jrnelson90/tinderboxpedal/src.midi/README.md

# USB MIDI footswitch for Positive Grid Spark

Supported / tested USB MIDI footswitches: 

 - Icon G-Board

## Quick start

You will need:

 - a supported footswitch
 - a Raspberry Pi 4 (2Gb version should work, 4Gb version was used). It gets hot, invest a few $$s for good passive cooling enclosure. You will need a power supply as well, the official one may be the safest way
 - Ubuntu 20.04 LTS from https://ubuntu.com/download/raspberry-pi installed on a SD card

Unfortunately, my Pi doesn't boot with the MIDI controller attached, making it not possible to autostart the script in its current form. You will need a display and keyboard or set up SSH connction until the issue is resolved.

Following packages should be installed:

    sudo apt install pi-bluetooth
    sudo apt install python3-bluez
    sudo apt install python3-rtmidi

and restart the Pi.

Make sure that no other Bluetooth device is connected to your Spark, and start the script with

    python3 ./midibox.py

You should see messages about MIDI devices and Spark discovered (the Spark discovery may take some seconds)

The top row of the footswitch is changing amp presets.
