jrnelson90/tinderboxpedal/src/flame.gif

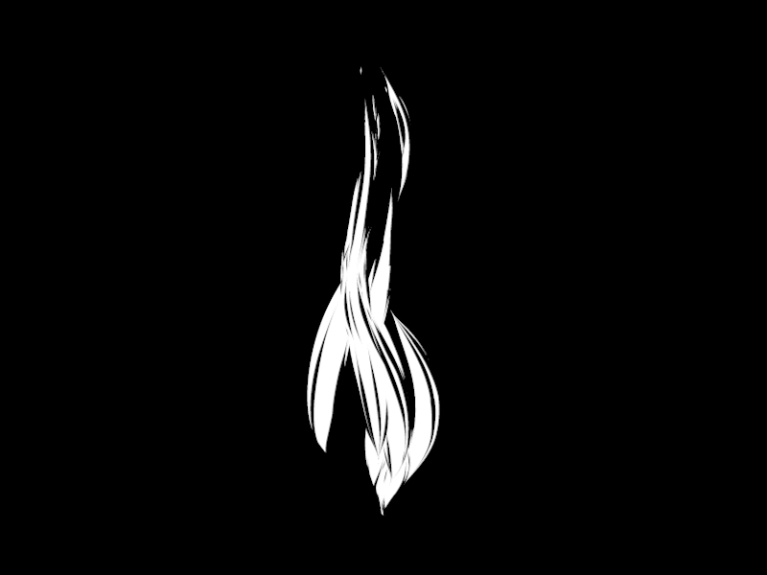
src/flame.gif
