jrnelson90/tinderboxpedal/(threads)

Thread 4 (2020-08-03):

May I ask how do you find out these command code?

janzhen, 2020-08-03:
Hi Justin, thanks for your excellent work. May I ask how do you find out these command codes?

```python
TONE_1 = "01fe000053fe1a000000000000000000f00124000138000000f779"
TONE_2 = "01fe000053fe1a000000000000000000f00123010138000001f779"
TONE_3 = "01fe000053fe1a000000000000000000f00125020138000002f779"
TONE_4 = "01fe000053fe1a000000000000000000f00120030138000003f779"
```

jrnelson90, 2020-08-04:
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

By packet sniffing the app's BT controls, just like how a universal remote learns your TVs IR controls
https://www.wireshark.org/

janzhen, 2020-08-05:
@jrnelson90 Thank you. I didn't know Wireshark can also sniff Bluetooth.

Closed 2020-08-05.

Thread 5 (2020-08-14):

ESP32 BT Connectivity with Arduino-Core

jrnelson90, 2020-08-14:
Unlike the Pi version based on the PyBluez stack, the Arduino-Core BT stack will intermittently disconnect from the Spark after periods of disuse. A callback on disconnect currently calls a the connection method to compensate for this, but it would be better if this could be fix with a ping message short term, and better Bluetooth connection code long term,

Thread 6 (2020-08-14):

Pi Boot Up Time

jrnelson90, 2020-08-14:
45 seconds on a Pi Zero is much longer than the near instant bootup of the ESP32 version. While complete match in startup performance should not be expected, minimizing this disparity via scripts or a custom light image would be a great improvement.

juliengdt, 2020-11-23:
Ahoy, what's your boot time on ESP32 ?
Nice work, actually modding a footswitch to integrate a Pi0W with tinderBox !

Cheers from France 🇫🇷
Julien

Thread 7 (2020-09-29):

Not an issue but a question.

bigtiny, 2020-09-29:
How did you get the bluetooth codes for the different buttons and is there more code that could be used for different functions?

jrnelson90, 2020-10-11:
Yes, I'm working on code for more functionality, but at the moment I don't have a build stable enough yet to feel comfortable releasing it to others yet.

As for how, I use Android Debugginh and Wireshark to see what BT commands (packets) are being sent when you edit the tone in the app. Then, like a universal remote, we can use that in the project to control the amp.

Thread 12 (2020-11-18):

Not issue - but this might be helpful for Spark traffic sniffing

paulhamsh, 2020-11-18:
Hi Justin
Very impressed with what you and team have done here!!

I haven't tried Wireshark, but wrote this for an ESP32 board (M5Stack Core2) to appear to the Spark app as the amp and record the traffic sent to the amp and show it on the Serial Monitor (in the Arduino program).

Next step is to send this over wifi to something connected to the actual amp (via bluetooth) and capture the return traffic - I've started on that using a Pi 400.

Only works with Android - I think iPhone must use BLE not bluetooth serial?

https://github.com/paulhamsh/SparkSpoofer/blob/main/Spark_Server_Core_3_SerialOnly.ino

Paul

Thread 14 (2021-01-21):

Oled Display doesn't work

Tranks76, 2021-01-21:
Hi there! Such a great job you are doing here. I really appreciate it.
I am just starting on arduino and I am really bad at it. I am just an Electrician.
The issue I have is about the Oled Display. The switch foot works great but the screen does not do enything.
I've checked the librery and all is ok.
Olso I checked the Oled Display with the Elegoo Uno R3 board and it works fine.

The board I have is from AZ-Delivery and the modell is ESP32-WROOM-32

The screen is too from AZ-Delivery and the modell is Oled Display I2C 128X64

I don't know what else try.
I'll aprreciate any sugestion.

Thank you so much.

Skiddz, 2021-01-23:
Justin, awesome work on the Tinderbox..  Appreciate the work and wish I had the knowledge to do this kind of stuff.

I had the same issue as Tranks76 above.  Switches work just fine (I did find a discrepancy between the schematic and the code - switches 3 and 4 were 'transposed' - I just flipped the wires) but I got nothing on the display.

Looking at a pinout for the ESP32 DevkitC, I found SCL is pin 22, *not* 23 as depicted in the schematic.  Once I switched the SCL line to pin 22, the display came right up.

Tranks76, 2021-02-04:
Hi Skiddz. I noticed to de discrepancy between the switches and the shcematic. And I did change the 22/23 pins and now the oled it works fine! Thank you so mach! so many time spended looking for the issue.

happyhappysundays, 2021-06-01:
Hi all, I found the same two errors in the schematic. Buttons 3 and 4 transposed and SCL needs to be on GPIO22 as is standard. I hope the schematic is updated one day.

Thread 16 (2021-06-01):

Schematic errors

happyhappysundays, 2021-06-01:
Hi all, I found the same two errors as others have in the schematic. Buttons 3 and 4 transposed and SCL needs to be on GPIO22 as is standard. I hope the schematic is updated one day.
