jrnelson90/tinderboxpedal/src/tinderbox_ESP32/tinderbox/spark.h

const String SPARK_BT_NAME = "Spark 40 Audio";

const int LOAD_TONE_PRESET_CMD_SIZE = 27;

byte LOAD_TONE_PRESET_1_CMD[] = {
  0x01, 0xFE, 0x00, 0x00,
  0x53, 0xFE, 0x1A, 0x00,
  0x00, 0x00, 0x00, 0x00,
  0x00, 0x00, 0x00, 0x00,
  0xF0, 0x01, 0x24, 0x00,
  0x01, 0x38, 0x00, 0x00,
  0x00, 0xF7
};

byte LOAD_TONE_PRESET_2_CMD[] = {
  0x01, 0xFE, 0x00, 0x00,
  0x53, 0xFE, 0x1A, 0x00,
  0x00, 0x00, 0x00, 0x00,
  0x00, 0x00, 0x00, 0x00,
  0xF0, 0x01, 0x24, 0x00,
  0x01, 0x38, 0x00, 0x00,
  0x01, 0xF7
};

byte LOAD_TONE_PRESET_3_CMD[] = {
  0x01, 0xFE, 0x00, 0x00,
  0x53, 0xFE, 0x1A, 0x00,
  0x00, 0x00, 0x00, 0x00,
  0x00, 0x00, 0x00, 0x00,
  0xF0, 0x01, 0x24, 0x00,
  0x01, 0x38, 0x00, 0x00,
  0x02, 0xF7
};

byte LOAD_TONE_PRESET_4_CMD[] = {
  0x01, 0xFE, 0x00, 0x00,
  0x53, 0xFE, 0x1A, 0x00,
  0x00, 0x00, 0x00, 0x00,
  0x00, 0x00, 0x00, 0x00,
  0xF0, 0x01, 0x24, 0x00,
  0x01, 0x38, 0x00, 0x00,
  0x03, 0xF7
};

byte* LOAD_TONE_PRESET_LIST[] = {
  LOAD_TONE_PRESET_1_CMD, 
  LOAD_TONE_PRESET_2_CMD, 
  LOAD_TONE_PRESET_3_CMD, 
  LOAD_TONE_PRESET_4_CMD
};
