jrnelson90/tinderboxpedal/(commit log)

2020-07-24 fixes to client script
    [tinderbox.py]
2020-07-24 fix flashing screen with new luma code
    [tinderbox.py]
2020-07-24 prevent sending duplicate presses
    [tinderbox.py]
2020-07-25 initial client connection logic via pedal button input
2020-07-27 Fixes to previous refactors of tinderbox.py
    [tinderbox.py]
2020-07-28 fixed new refactor scope issues in tinderbox.py
    [tinderbox.py]
2020-07-28 Initial work on multi button disconnect logic
2020-07-28 more client fixes for disconnects
    [tinderbox.py]
2020-07-28 Initial BT Device Scan Results Scrolling View
2020-07-28 refactor fix for tinderbox.py
    [tinderbox.py]
2020-07-28 fix for sub-listing BT devices detected
    [tinderbox.py]
2020-07-28 Centering version text fix
    [tinderbox.py]
2020-07-28 Fix to exit message in demo server
    [demoLedServer.py]
2020-07-30 Hat Schematic, other Readme updates
2020-08-07 Fix to improve resource file path resolution
    [tinderbox.py]
2020-08-11 Initial commit of TinderBox Pedal ESP32 code for Spark tone switching
2020-08-11 Cleanup ESP32 folder/file name
2020-08-11 Directory edit to make Arduino IDE happy
2020-08-12 Code cleanup, improved comments, fixed BT logic on disconnect
    [spark.h, tinderbox.ino]
2020-09-21 Add files via upload
    Basic ESP32 schematic with 4 buttons and LiPo Battery/Charging board
2020-09-21 Update README.md
    Added ESP32 Schematic
2020-09-21 Updated ESP32 schematic
2020-09-21 Fixed ESP32 schematic
2020-10-11 Control Spark using a Icon G-Board USB MIDI footswitch
2020-10-11 Update README.md
    Updates for ESP32 setup
2020-10-12 fix off-by-one error, LED 4 was not possible to activate
